tinytiming/tinyLINK/firmware/README.md

# tinyLINK firmware

Pico SDK firmware for the [tinyLINK hardware](../hardware/README.md). One image holds all eight
modes. The mode is saved in flash; switching modes reboots so USB re-enumerates with that mode's
interfaces.

## Using it

- **BOOT, short press:** next mode (saved, reboots).
- **BOOT, hold 1.5 s:** toggle target power. The LED blinks white once on power on/off, and red twice
  on a fault or refusal.
- **LED:** mode colour (table below).
- **Target power** is off at every boot and needs JP9 bridged. The probe refuses to switch it on if
  VTGT is already above 0.5 V (a self-powered target). After switch-on VTGT must reach 2.8 V within
  20 ms, and while on it must not sag below 2.5 V for 3 ms. Otherwise power goes off, the LED blinks
  red twice and the console prints `target power fault: short/overload or JP9 open` (or
  `short/overload` for a sag).
- **Leakage VTGT:** with the I/O lines active, an unpowered target can lift VTGT through its I/O
  protection diodes (1.86 V measured on an RP235x during SWD), which blocks power-on.
  `power leak on` (saved, off by default) allows power-on up to 2.5 V and logs the VTGT it saw. Only
  turn it on for targets without their own supply below 2.5 V: those would be back-fed.
- **IO0/IO1 swap:** `swap on` (saved, off by default) exchanges IO0 and IO1 in the SWD, JTAG and WCH
  modes, for targets wired the other way round: SWCLK/TCK goes to IO1 and SWDIO/TMS/SWIO to IO0, on
  J1 and J3 alike (on a Pico/picoprobe PCB: the SWDCLK and SWDIO header pins). In those modes it
  reboots to apply, which turns target power off like a mode change. UPDI, UART, LA, SPI and ISP are
  unaffected.
- **Level shifter:** U2 (SHIFT_OE) is enabled while VTGT >= 3.1 V and disabled below 3.0 V, with
  VTGT = ADC0 × 2. With U2 fitted every mode, including the logic analyser, needs VTGT (from the
  target or probe power).

Every mode has a **console** port (the last CDC port, "tinyLINK console"), any baud rate:

```
status          mode, VTGT, power, level shifter
mode [N|name]   list modes, or switch
power on|off    target power
power leak on|off  allow power-on with leakage VTGT (< 2.5 V), saved
swap on|off     exchange IO0/IO1 in SWD/JTAG/WCH, saved
pinout          pins of the current mode
boot            reboot into the UF2 bootloader
reset           reboot
```

`pinout` (also printed at the top of `help`) lists the signals the current mode uses, with swap applied:
IO channel, GPIO and connector pins (2x10 header, SWD/UART JST and Cortex 10-pin on tinyLINK; Pico pin and
picoprobe 7-pin/Cortex 10-pin headers on a Pico).

`tools/tinylink.sh` has shell helpers (source it from `~/.zshrc` or `~/.bashrc`): `tlport [<serial>]`
lists a tinyLINK's ports and `tl [<serial>]` opens its console (Ctrl-D quits), on macOS and Linux.
Without a serial they use the first tinyLINK found; a serial prefix such as the board id works in any mode.

Opening and closing the console at 1200 baud also reboots into the UF2 bootloader.

| # | Mode | LED | USB ports (in order) | Host tools |
|---|---|-----|---|---|
| 1 | `swd`  | green  | CMSIS-DAP v2, target UART, console | OpenOCD (`interface/cmsis-dap.cfg`), probe-rs, pyOCD |
| 2 | `wch`  | purple | SWIO (ardulink), target UART, console | `minichlink -c /dev/ttyACM0 -w fw.bin flash -b` |
| 3 | `updi` | yellow | SerialUPDI, target UART, console | `pymcuprog -t uart -u /dev/ttyACM0 -d attiny1616 ...`, `avrdude -c serialupdi -P /dev/ttyACM0 ...` |
| 4 | `uart` | white  | target UART, console | any terminal, `esptool.py` (auto-reset) |
| 5 | `la` | blue | sigrok, console | PulseView / sigrok-cli, driver `raspberrypi-pico` |
| 6 | `spi`  | orange | serprog, console | `flashrom -p serprog:dev=/dev/ttyACM0,spispeed=8M` |
| 7 | `jtag` | cyan | CMSIS-DAP v2 (JTAG default), target UART, console | OpenOCD, openFPGALoader (`-c cmsisdap`) |
| 8 | `isp`  | red | STK500v2, console | `avrdude -c stk500v2 -P /dev/ttyACM0 -p m328p ...` |

The protocol port is always the first CDC port: the lowest `ttyACMn` on Linux, and
`/dev/serial/by-id/` names ending in `-if00` (`-if01` in the CMSIS-DAP modes). Each mode has its
own USB serial number (`<board id>-<mode name>`, e.g. `E6614C30935B1329-swd`), so Windows keeps a
driver binding per mode. CMSIS-DAP uses WinUSB via MS OS 2.0 descriptors, so it needs no driver
install.

Pins per mode: see the [channel table](../hardware/README.md#channels) (with `swap on`, IO0 and IO1 trade
places in SWD/JTAG/WCH). PulseView names the channels
D2-D9 after the GPIO numbers, so D2 = IO0. nRESET, the ESP32 EN/BOOT lines and the AVR RESET are
open-drain.

### Mode notes

- **SWD / JTAG:** [free-dap](https://github.com/ataradov/free-dap) bit-banged on SIO. Both modes
  accept SWD and JTAG and differ only in the default port. The clock delays are scaled from free-dap's
  RP2040 port and still need measuring (fast path about 8.9 MHz).
- **WCH:** SWIO for CH32V003/V00x with PicoRVD's PIO program, speaking minichlink's "ardulink" serial
  protocol. That's one USB round trip per debug register access: slower than a WCH-LinkE, fine for
  16 KB parts. minichlink's power on/off maps to target power, so it can power-cycle a locked chip.
  The probe only pulls SWIO low or releases it, so the line relies on pull-ups: the level shifter's
  own on rev A (add no external one), about 1k to 3V3 on a plain Pico; see the
  [SWIO pull-up note](../hardware/README.md#open-questions-for-future-revisions).
- **UPDI:** PIO open-drain half-duplex UART on IO1. The probe echoes its own bytes like the resistor
  SerialUPDI adapter, follows the host's baud rate, parity and stop bits (including pymcuprog's
  300-baud double break) and handles a CDC break.
- **UART:** UART1 on IO2/IO3. RTS/DTR follow esptool's auto-reset logic: RTS alone pulls EN low, DTR
  alone pulls BOOT low.
- **LA:** up to 131072 samples into RAM (PIO + DMA, 5 kS/s to 100 MS/s), then streamed. One capture
  per run, so PulseView's software trigger only fires inside that window. No analog channels.
- **SPI:** SPI0, mode 0, up to 30 MHz (default 8 MHz). Pins stay high-Z until flashrom's first SPI
  operation and after it releases them.
- **ISP:** STK500v2 (AVR068) on SPI0. Default SCK 230.4 kHz, for targets at 1 MHz and up; `-B`
  SCK_DURATION 0/1/2/3 = 921.6/230.4/57.6/28.8 kHz. Pins stay high-Z outside programming mode.

## Building

Pico SDK 2.x (built with 2.2.0) and arm-none-eabi-gcc:

```sh
cd tinyLINK/firmware
mkdir -p build && cd build
cmake .. -DPICO_SDK_PATH=$PICO_SDK_PATH
make -j8
```

Flash `firmware/build/tinylink.uf2`: hold BOOT while plugging in the RP2040-Zero and copy it to the
RPI-RP2 drive. Later updates: `boot` on the console, or the 1200-baud touch. Without an installed
picotool, cmake downloads and builds one (set `picotool_DIR` to avoid that).

`cmake .. -DLED_ORDER_RGB=ON` for RP2040-Zero LEDs that take R,G,B instead of the usual G,R,B.

CI builds both UF2s (RP2040-Zero and Pico) on every push; tagged releases (`v*`) attach them.

## Raspberry Pi Pico / picoprobe PCB

The same firmware runs on a plain Raspberry Pi Pico, for example on the
[picoprobe PCB](https://github.com/Fabien-Chouteau/picoprobe-pcb):

```sh
cmake -B build-pico -DPICO_BOARD=pico -DPICO_SDK_PATH=$PICO_SDK_PATH
make -C build-pico -j8
```

- **LED (GP25):** blinks the mode number (1-8) every 2 s; a fast flicker for power on/off, faults
  and refusals.
- **No level shifter or power switch:** 3.3 V targets only, powered by themselves. `power on` is
  refused.
- **VTREF:** the picoprobe PCB routes VTREF to Pico pin 34 (GP28), not to 3V3. The firmware reads it
  on ADC2 (no divider) as VTGT for `status`, minichlink's power check and avrdude's VTARGET, and
  never drives GP28.
- **SWIO / UPDI:** IO1 only has the RP2040's internal pull-up here. Add 1k from SWDIO (GP3) to 3V3
  for WCH SWIO; WCH flashing was tested with that pull-up fitted.

IO0-IO3 (GP2-GP5) land on the picoprobe headers. The picoprobe PCB's RESET pin is GP4 (IO2), so on
the Pico build nRESET/nSRST (and ESP32 EN in UART mode) sit on GP4 and the target UART TX moves to
GP20 (Pico pin 26, flying lead). The rest are only on the Pico's own pins, for a flying lead:

| Picoprobe signal (7-pin / Cortex 10) | GPIO | SWD | WCH | UPDI | UART | LA | SPI | JTAG | ISP |
|---|---|---|---|---|---|---|---|---|---|
| SWDCLK (2 / 4) | GP2 | SWCLK | | | | D2 | SCK | TCK | SCK |
| SWDIO (4 / 2) | GP3 | SWDIO | SWIO | UPDI | | D3 | MOSI | TMS | MOSI |
| RESET (5 / 10) | GP4 | nRESET | | | EN | D4 | MISO | nSRST | MISO |
| SWO (6 / 6) | GP5 | RX | RX | RX | RX | D5 | CS | RX | |
| Pico pin 9 | GP6 | | | | | D6 | | | RESET |
| Pico pin 10 | GP7 | | | | BOOT | D7 | | TDO | |
| Pico pin 11 | GP8 | | | | | D8 | | TDI | |
| Pico pin 12 | GP9 | | | | | D9 | | | |
| Pico pin 26 | GP20 | TX | TX | TX | TX | | | TX | |

VTREF is 7-pin 1 / Cortex 10 pin 1 (Pico pin 34, GP28). GND is 7-pin 3, or Cortex 10 pins 3/5.

## Not done yet

- Tested so far: WCH and SWD, on rev A and on a Raspberry Pi Pico (picoprobe PCB). The other
  modes are untested.
- USB VID/PID is the pid.codes test pair 1209:0001; a public release needs its own PID (free from
  pid.codes for open hardware).
- Not implemented: WCH RVSWD (CH32V2xx/V3xx/X0), SWO, dirtyJTAG, UART CTS/RTS flow control, LA RLE
  compression and streaming triggers.

## Licences

MIT, see [`../LICENSE`](../LICENSE). `third_party/free-dap`: BSD-3-Clause (Alex Taradov).
`src/swio.pio`: from PicoRVD, MIT (aappleby). `src/ws2812.pio` and the BOOTSEL read in
`src/button.c` follow pico-examples (BSD-3-Clause, Raspberry Pi). The sigrok and STK500v2 protocols
were implemented from their descriptions.
