tinytiming/tinyLINK/hardware/RP2040-Zero-Kicad-Fixed/README.md

# RP2040-Zero-Kicad
Kicad 6 Footprint and Symbol for Waveshare RP2040-Zero 







Pads to solder the castellated edges to. You can add a cutout to get the baord flush to your pcb.

NOTE
====

Tiny pad under the pcb are not included in the footprint and symbol.
