tinytiming/tinyLINK/hardware/revA/fab/tinylink-BOM-JLC.csv

Comment | Designator | Footprint | LCSC
100nF | C1,C2,C3,C5 | Capacitor_SMD:C_0603_1608Metric_Pad1.08x0.95mm_HandSolder | C14663
10uF | C4 | Capacitor_SMD:C_0603_1608Metric_Pad1.08x0.95mm_HandSolder | C19702
1N5819WS | D1 | EasyEDA:SOD-323_L1.8-W1.3-LS2.5-RD | C191023
KT-0603R | D2 | EasyEDA:LED-SMD_L1.6-W0.8-R-RD_Pad1K | C2286
500mA | F1 | Fuse:Fuse_0603_1608Metric_Pad1.05x0.95mm_HandSolder | C210357
HC-1.0-3PWT | J1,J2 | Connector_JST:JST_SH_SM03B-SRSS-TB_1x03-1MP_P1.00mm_Horizontal | C2845362
AO3401A | Q1,Q2 | EasyEDA:SOT-23_L2.9-W1.3-P1.90-LS2.4-BR | C15127
BSS138 | Q3 | EasyEDA:SOT-23-3_L2.9-W1.3-P1.90-LS2.4-BR | C7420339
33R | R1,R2,R3,R4,R5,R6,R7,R8 | Resistor_SMD:R_0603_1608Metric_Pad0.98x0.95mm_HandSolder | C23140
100k | R9,R12,R13 | Resistor_SMD:R_0603_1608Metric_Pad0.98x0.95mm_HandSolder | C25803
10k | R10,R11,R14,R15 | Resistor_SMD:R_0603_1608Metric_Pad0.98x0.95mm_HandSolder | C25804
2.2k | R16 | Resistor_SMD:R_0603_1608Metric_Pad0.98x0.95mm_HandSolder | C4190
TXS0108EPWR | U2 | Package_SO:TSSOP-20_4.4x6.5mm_P0.65mm | C17206
