tinytiming/tinyLINK/firmware/src/settings.h

#pragma once
#include <stdint.h>

#define SETTING_POWER_ALLOW_LEAK  (1u << 0)   // power on with leakage VTGT (< 2.5 V)
#define SETTING_SWAP_IO01         (1u << 1)   // SWD/JTAG/WCH: IO0 and IO1 exchanged

int settings_load_mode(void);        // -1 when nothing valid is saved
void settings_save_mode(int mode);
uint32_t settings_load_flags(void);  // 0 when nothing valid is saved
void settings_save_flags(uint32_t flags);
