tinytiming/tinyLINK/firmware/src/tusb_config.h

#pragma once

#define CFG_TUSB_RHPORT0_MODE   OPT_MODE_DEVICE
#define CFG_TUSB_OS             OPT_OS_PICO
#define CFG_TUD_ENDPOINT0_SIZE  64

// Up to three CDC ports (protocol, target UART, console) plus CMSIS-DAP v2.
#define CFG_TUD_CDC             3
#define CFG_TUD_VENDOR          1
#define CFG_TUD_HID             0
#define CFG_TUD_MSC             0
#define CFG_TUD_MIDI            0

#define CFG_TUD_CDC_RX_BUFSIZE  1024
#define CFG_TUD_CDC_TX_BUFSIZE  1024
#define CFG_TUD_CDC_EP_BUFSIZE  64

#define CFG_TUD_VENDOR_RX_BUFSIZE 64
#define CFG_TUD_VENDOR_TX_BUFSIZE 64
