tinytiming/tinyLINK/(commit log)

2026-10-29 document solder jumpers
2026-10-29 rpi pico / picoprobe support
2026-11-04 fix LED on RP2040-Zero
2026-11-06 power leak setting, console async messages
    - `power leak on|off` (saved, off by default) allows target power-on while VTGT is
    only I/O leakage (< 2.5 V, e.g. 1.86 V from an unpowered RP235x during SWD)
    - settings: flags record after the mode record, old sectors read as off
    - "target power on" reports the settled VTGT, 30 ms after power-good;
    `power on` and minichlink's power-on wait for it
    - async console messages redraw the prompt and the partly typed line
2026-11-06 add IO0/IO1 swap setting
    - `swap on|off` (saved, off by default) exchanges IO0 and IO1 in the SWD, JTAG
    and WCH modes; reboots into the current mode to apply
    - UPDI, UART, LA, SPI and ISP keep their pins
2026-11-06 pico: reset on GP4 like the picoprobe PCB, TX on GP20, SWDIO/nRESET pull-ups
2026-11-06 README: SWD tested on rev A and Pico
